mitcheltu/KappaBetaEngineeringProject/Software/WebApp/assets/ocean-background.png

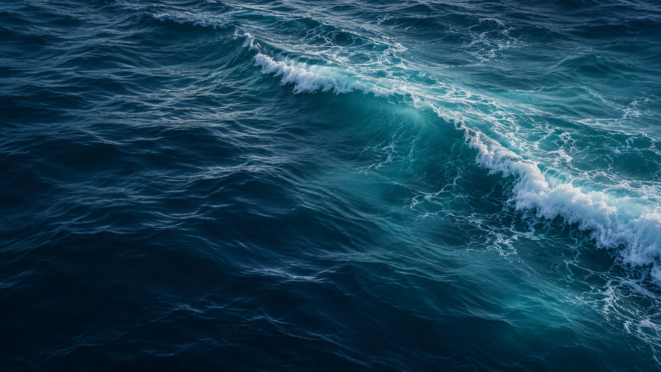
Software/WebApp/assets/ocean-background.png
