mitcheltu/KappaBetaEngineeringProject/Software/archive/README.md

# Archived firmware

`DrowningWearable_legacy.ino` is the older monolithic firmware sketch preserved
during the project consolidation. The active Arduino sketch is the modular
`Software/DrowningWearable/` folder; the archived sketch is not part of the
current build.
