mitcheltu/KappaBetaEngineeringProject/Mechanical/tt_electronics_enclosure.SLDPRT

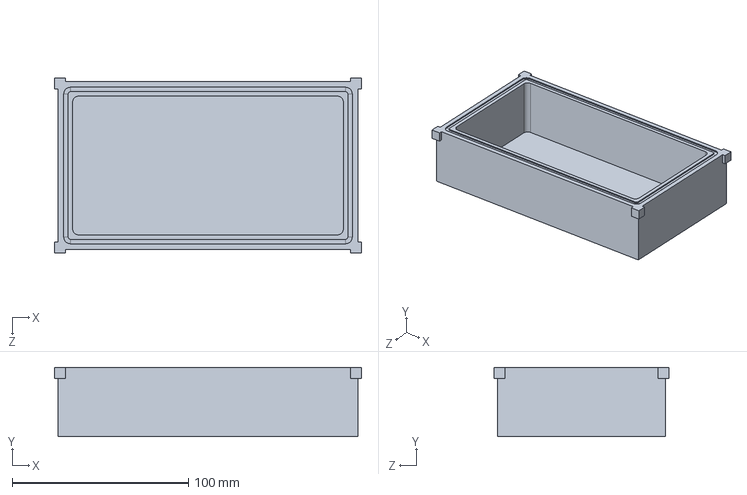
[picture p2: CAD file, 2026-10-26]
Mechanical/tt_electronics_enclosure.SLDPRT
174.3 x 39.4 x 99.4 mm
