mitcheltu/KappaBetaEngineeringProject/Mechanical/tt_base_plate.SLDPRT

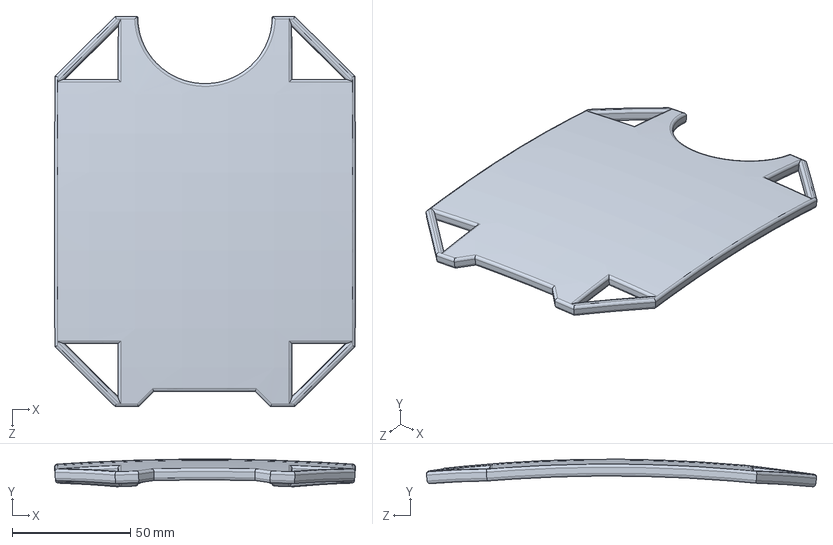
[picture p3: CAD file, 2026-10-26]
Mechanical/tt_base_plate.SLDPRT
127.3 x 11.7 x 165.0 mm
