mitcheltu/KappaBetaEngineeringProject/Mechanical/tt_electronics_lid_v1.SLDPRT

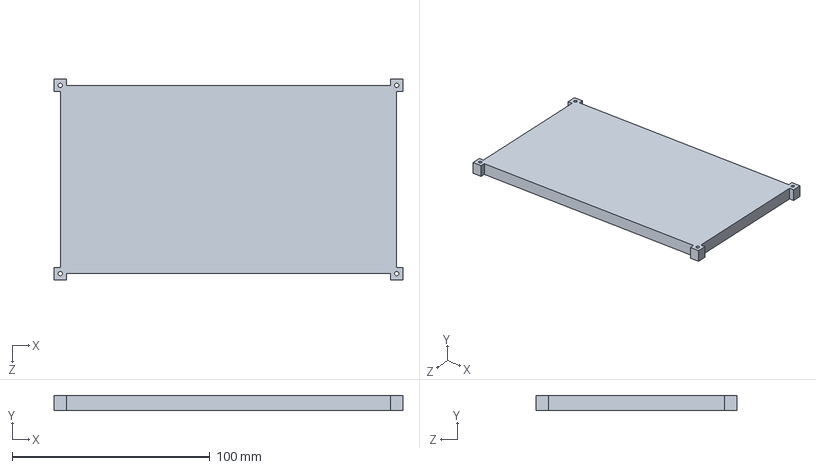
[picture p4: CAD file, 2026-10-26]
Mechanical/tt_electronics_lid_v1.SLDPRT
176.5 x 7.62 x 101.6 mm
