mitcheltu/KappaBetaEngineeringProject/Software/tests/ppg/pulse_peak_cases.csv

case | distance | sample | value
plateaus_threshold | 30 | 0 | 0
plateaus_threshold | 30 | 1 | 0
plateaus_threshold | 30 | 2 | 0
plateaus_threshold | 30 | 3 | 0
plateaus_threshold | 30 | 4 | 0
plateaus_threshold | 30 | 5 | 0
plateaus_threshold | 30 | 6 | 0
plateaus_threshold | 30 | 7 | 0
plateaus_threshold | 30 | 8 | 0
plateaus_threshold | 30 | 9 | 0
plateaus_threshold | 30 | 10 | 1
plateaus_threshold | 30 | 11 | 1
plateaus_threshold | 30 | 12 | 1
plateaus_threshold | 30 | 13 | 1
plateaus_threshold | 30 | 14 | 0
plateaus_threshold | 30 | 15 | 0
plateaus_threshold | 30 | 16 | 0
plateaus_threshold | 30 | 17 | 0
plateaus_threshold | 30 | 18 | 0
plateaus_threshold | 30 | 19 | 0
plateaus_threshold | 30 | 20 | 0
plateaus_threshold | 30 | 21 | 0
plateaus_threshold | 30 | 22 | 0
plateaus_threshold | 30 | 23 | 0
plateaus_threshold | 30 | 24 | 0
plateaus_threshold | 30 | 25 | 0
plateaus_threshold | 30 | 26 | 0
plateaus_threshold | 30 | 27 | 0
plateaus_threshold | 30 | 28 | 0
plateaus_threshold | 30 | 29 | 0
plateaus_threshold | 30 | 30 | 0
plateaus_threshold | 30 | 31 | 0
plateaus_threshold | 30 | 32 | 0
plateaus_threshold | 30 | 33 | 0
plateaus_threshold | 30 | 34 | 0
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
