mitcheltu/KappaBetaEngineeringProject/Software/tests/ppg/pulse_peak_expected.csv

case | sample | prominence
plateaus_threshold | 11 | 1
plateaus_threshold | 46 | 1.5
plateaus_threshold | 90 | 0.29999999999999999
distance_before_prominence | 10 | 1
distance_before_prominence | 45 | 2
distance_before_prominence | 80 | 1
equal_height_distance | 20 | 1
equal_height_distance | 60 | 1
equal_height_distance | 100 | 1
nested_bases | 1 | 1
nested_bases | 3 | 2
nested_bases | 5 | 1
nested_bases | 7 | 4
nested_bases | 9 | 1
mixed_ties_unsupported | 30 | 2
mixed_ties_unsupported | 60 | 2
mixed_ties_unsupported | 100 | 2
mixed_ties_unsupported | 140 | 2
mixed_ties_unsupported | 180 | 2
mixed_ties_unsupported | 230 | 2
mixed_ties_unsupported | 270 | 2
mixed_ties_unsupported | 300 | 2
mixed_ties_unsupported | 350 | 2
mixed_ties_unsupported | 380 | 2
mixed_ties_unsupported | 420 | 2
mixed_ties_unsupported | 470 | 2
mixed_ties_unsupported | 500 | 2
mixed_ties_unsupported | 550 | 2
mixed_ties_unsupported | 590 | 2
mixed_ties_unsupported | 620 | 2
mixed_ties_unsupported | 660 | 2
mixed_ties_unsupported | 710 | 2
mixed_ties_unsupported | 750 | 2
mixed_ties_unsupported | 780 | 2
mixed_ties_unsupported | 830 | 2
mixed_ties_unsupported | 860 | 2
mixed_ties_unsupported | 900 | 2
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
