mitcheltu/KappaBetaEngineeringProject/Software/tests/ppg/oxygen_golden.csv

case | start | full | auto_clear | second | spo2 | valid | concern | active
normal | 80.0 | 60.0 | 0 | 0 | 98 | 1 | nan | 0
normal | 80.0 | 60.0 | 0 | 1 | 98 | 1 | nan | 0
normal | 80.0 | 60.0 | 0 | 2 | 98 | 1 | 0 | 0
normal | 80.0 | 60.0 | 0 | 3 | 98 | 1 | 0 | 0
normal | 80.0 | 60.0 | 0 | 4 | 98 | 1 | 0 | 0
normal | 80.0 | 60.0 | 0 | 5 | 98 | 1 | 0 | 0
normal | 80.0 | 60.0 | 0 | 6 | 98 | 1 | 0 | 0
normal | 80.0 | 60.0 | 0 | 7 | 98 | 1 | 0 | 0
normal | 80.0 | 60.0 | 0 | 8 | 98 | 1 | 0 | 0
normal | 80.0 | 60.0 | 0 | 9 | 98 | 1 | 0 | 0
normal | 80.0 | 60.0 | 0 | 10 | 98 | 1 | 0 | 0
normal | 80.0 | 60.0 | 0 | 11 | 98 | 1 | 0 | 0
normal | 80.0 | 60.0 | 0 | 12 | 98 | 1 | 0 | 0
normal | 80.0 | 60.0 | 0 | 13 | 98 | 1 | 0 | 0
normal | 80.0 | 60.0 | 0 | 14 | 98 | 1 | 0 | 0
normal | 80.0 | 60.0 | 0 | 15 | 98 | 1 | 0 | 0
normal | 80.0 | 60.0 | 0 | 16 | 98 | 1 | 0 | 0
normal | 80.0 | 60.0 | 0 | 17 | 98 | 1 | 0 | 0
normal | 80.0 | 60.0 | 0 | 18 | 98 | 1 | 0 | 0
normal | 80.0 | 60.0 | 0 | 19 | 98 | 1 | 0 | 0
initial_low | 80.0 | 60.0 | 0 | 0 | 60 | 1 | nan | 0
initial_low | 80.0 | 60.0 | 0 | 1 | 60 | 1 | nan | 0
initial_low | 80.0 | 60.0 | 0 | 2 | 60 | 1 | 1 | 0
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
