mitcheltu/KappaBetaEngineeringProject/Software/tests/ppg/pulse_expected.csv

case | max_gap_s | tail_gap_s | n_beats | hr_median | hr_min5 | ibi_cv | amp_tail_ratio | spectral_purity | flat_fraction | kurtosis | rule_score | rule_high_sensitivity | rule_high_specificity | logistic_score | logistic_high_sensitivity | logistic_high_specificity | boosted_score | boosted_high_sensitivity | boosted_high_specificity | cnn_score | cnn_high_sensitivity | cnn_high_specificity
normal | 0.8499999999999996 | 0.8300000000000001 | 19 | 72.28915662650601 | 71.77033492822967 | 0.007170658864360059 | 0.9834620611084873 | 0.9606119034802711 | 0.027517198248905566 | -1.3645968201335694 | 0.0 | 0 | 0 | 0.339762225824646 | 1 | 0 | 0.004903871998024693 | 0 | 0 | 0.25206542015075684 | 0 | 0
brady | 2.2699999999999996 | 2.2699999999999996 | 7 | 27.02702702702704 | 27.027027027027025 | 0.010449778627866509 | 0.8217027037377417 | 0.8758534798037398 | 0.056910569105691054 | -1.2093499450958982 | 1.0 | 1 | 1 | 0.5250571312791127 | 1 | 0 | 0.7862586210842474 | 1 | 1 | 0.6372581720352173 | 1 | 1
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
