mitcheltu/KappaBetaEngineeringProject/Software/tests/ppg/pulse_peaks.csv

case | sample | prominence
normal | 15 | 0.38883108311755621
normal | 99 | 0.99084051001037166
normal | 182 | 1.0218599852947829
normal | 266 | 1.0113197796369453
normal | 349 | 1.0140433324813984
normal | 432 | 1.0135785641496806
normal | 516 | 1.0137369140597867
normal | 599 | 1.0141508830026207
normal | 682 | 1.0133997646689439
normal | 766 | 1.0140496637266154
normal | 849 | 1.0141353097791286
normal | 932 | 1.0134555325873131
normal | 1016 | 1.0138939683185142
normal | 1099 | 1.0153014724942448
normal | 1182 | 1.0130543843935633
normal | 1266 | 1.0065305796033766
normal | 1349 | 1.0434822027916368
normal | 1432 | 0.98666592050735502
normal | 1517 | 0.98725727911364491
brady | 47 | 0.7270062117167988
brady | 263 | 1.0323827692160008
brady | 485 | 1.0333509685395463
brady | 708 | 1.0333314988720381
brady | 930 | 1.0330926958705486
brady | 1152 | 1.0260086210280692
brady | 1373 | 0.84870149961878583
pulse_stops | 15 | 0.40454103545090014
pulse_stops | 99 | 1.0308738638876851
pulse_stops | 182 | 1.070181878693035
pulse_stops | 266 | 1.0521815627560462
pulse_stops | 349 | 1.0547396051088251
pulse_stops | 432 | 1.0544737379258309
pulse_stops | 516 | 1.0552004344574961
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
