mitcheltu/KappaBetaEngineeringProject/Software/tests/ppg/pulse_waveforms.csv

case | sample | raw | prepared
normal | 0 | 100233.648 | 0.125228497419588
normal | 1 | 100540 | 0.16948745901142415
normal | 2 | 100837.938 | 0.21305983128056405
normal | 3 | 101124.523 | 0.25523807856740727
normal | 4 | 101397.039 | 0.29538780627490774
normal | 5 | 101653 | 0.33297037727448814
normal | 6 | 101890.242 | 0.36755163637315319
normal | 7 | 102106.891 | 0.39879936011957268
normal | 8 | 102301.43 | 0.42647356899145888
normal | 9 | 102472.688 | 0.45041384779897248
normal | 10 | 102619.859 | 0.4705269120827551
normal | 11 | 102742.516 | 0.48677637596213896
normal | 12 | 102840.562 | 0.49917543060548963
normal | 13 | 102914.281 | 0.5077821815835879
normal | 14 | 102964.25 | 0.51269681784469312
normal | 15 | 102991.359 | 0.51405958053714418
normal | 16 | 102996.758 | 0.51204858230936323
normal | 17 | 102981.836 | 0.50687678590662411
normal | 18 | 102948.156 | 0.49878777754178671
normal | 19 | 102897.445 | 0.48805028105992299
normal | 20 | 102831.539 | 0.47495160070146647
normal | 21 | 102752.297 | 0.4597903309366283
normal | 22 | 102661.633 | 0.44286873284154399
normal | 23 | 102561.398 | 0.42448516686464161
normal | 24 | 102453.398 | 0.40492691808172798
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
