mitcheltu/KappaBetaEngineeringProject/Software/microcontrollerFinal/DepthSensor.h

#pragma once

#include <Arduino.h>
#include <MS5837.h>
#include <Wire.h>
#include <cmath>
#include <cstddef>
#include <cstdint>

#include "FirmwareConfig.h"

#ifndef MS5837_H_BLUEROBOTICS
#error "Select BlueRobotics MS5837 Library by BlueRobotics; another MS5837 library was found."
#endif

// Quality is descriptive sensor state. It is deliberately separate from any
// fusion weights, action thresholds or risk scores.
using DepthQualityFlags = uint16_t;
namespace DepthQuality {
constexpr DepthQualityFlags NONE = 0;
constexpr DepthQualityFlags SENSOR_INVALID = 1u << 0;
constexpr DepthQualityFlags I2C_ERROR = 1u << 1;
constexpr DepthQualityFlags MISSING_BASELINE = 1u << 2;
constexpr DepthQualityFlags OUTLIER_REJECTED = 1u << 3;
constexpr DepthQualityFlags STALE = 1u << 4;
constexpr DepthQualityFlags RATE_UNAVAILABLE = 1u << 5;
constexpr DepthQualityFlags FILTER_WARMUP = 1u << 6;
constexpr DepthQualityFlags STOPPED = 1u << 7;
}

struct DepthSensorConfig {
  uint32_t samplePeriodMs = 200; // PROVISIONAL/TBD; 5 Hz initial cadence.
  float waterDensityKgM3 = 1000.0f; // PROVISIONAL/TBD freshwater/pool density.

  // These filter values are implementation defaults only, not safety-calibrated.
  uint8_t hampelWindowSamples = 5; // PROVISIONAL/TBD.
  float hampelDeviationThreshold = 3.0f; // PROVISIONAL/TBD MAD multiplier.
  float hampelMinimumDeviationM = 0.01f; // PROVISIONAL/TBD MAD floor.
  float emaAlpha = 0.25f; // PROVISIONAL/TBD.
  uint32_t regressionWindowMs = Config::DEPTH_REGRESSION_WINDOW_MS;
  uint8_t minimumRegressionSamples = 3; // PROVISIONAL/TBD.
  uint32_t staleAfterMs = Config::DEPTH_STALE_AFTER_MS; // PROVISIONAL/TBD.

  float minimumPressurePa = 0.0f;
  float maximumPressurePa = 3000000.0f;
  float minimumTemperatureC = -20.0f;
  float maximumTemperatureC = 85.0f;
};

struct DepthReading {
  uint64_t timestampUs = 0;
  float pressurePa = NAN;
  float temperatureC = NAN;
  float surfacePressurePa = NAN;
  float rawDepthM = NAN;
  float filteredDepthM = NAN;
  float depthRateMps = NAN;
  uint64_t rateWindowStartUs = 0;
  uint64_t rateWindowEndUs = 0;
  bool sensorValid = false;
  bool depthValid = false;
  bool rateValid = false;
  DepthQualityFlags qualityFlags = DepthQuality::SENSOR_INVALID |
                                    DepthQuality::MISSING_BASELINE |
                                    DepthQuality::RATE_UNAVAILABLE;
};

enum class DepthServiceEvent : uint8_t {
  NONE,
  SAMPLE_PUBLISHED,
  SURFACE_ZERO_PUBLISHED,
  CONVERSION_FAILED,
  SURFACE_ZERO_FAILED,
};

class DepthSensor {
 public:
  explicit DepthSensor(const DepthSensorConfig& config = DepthSensorConfig{});

  // The official MS5837 1.1.1 implementation uses the global Wire object and
  // the sensor's fixed 0x76 address internally. The arguments mirror ImuSensor
  // for call-site consistency and identify the bus/address being configured.
  bool begin(TwoWire& bus, uint8_t address);

  // Queues a fresh surface-pressure conversion and clears dive-only state.
  bool startDive();
  void stopDive();

  // Runs one nonblocking state-machine step. Call on every loop pass.
  DepthServiceEvent service();

  // Retained for standalone callers while they migrate to service().
  bool due(uint64_t nowUs) const;
  bool update();

  bool ready() const { return ready_; }
  bool diveActive() const { return diveActive_; }
  bool hasReading() const { return reading_.timestampUs != 0; }
  const DepthReading& reading() const { return reading_; }
  DepthReading snapshot(uint64_t nowUs) const;
  bool isStale(uint64_t nowUs) const;
  const DepthSensorConfig& config() const { return config_; }

 private:
  static constexpr size_t HISTORY_CAPACITY = 64;
  static constexpr uint64_t CONVERSION_TIME_US = 20000;

  enum class ConversionState : uint8_t {
    IDLE,
    WAITING_PRESSURE,
    WAITING_TEMPERATURE,
  };

  enum class ConversionKind : uint8_t {
    NORMAL_SAMPLE,
    SURFACE_ZERO,
  };

  struct HistorySample {
    uint64_t timestampUs = 0;
    float depthM = NAN;
    bool valid = false;
  };

  void invalidateReading(DepthQualityFlags flags);
  void invalidateReading(uint64_t timestampUs, float pressurePa,
                         float temperatureC, DepthQualityFlags flags);
  void resetDiveState();
  bool sensorPresent() const;
  bool writeCommand(uint8_t command);
  bool readAdc(uint32_t& value);
  bool readCalibrationWord(uint8_t index, uint16_t& value);
  bool loadCalibration();
  uint8_t crc4(uint16_t prom[8]) const;
  bool startConversion(uint8_t command, uint64_t timestampUs);
  bool compensate(uint32_t pressureAdc, uint32_t temperatureAdc,
                  float& pressurePa, float& temperatureC) const;
  DepthServiceEvent failConversion(uint64_t timestampUs,
                                   DepthQualityFlags flags);
  void processSample(uint64_t timestampUs, float pressurePa, float temperatureC);
  void updateDepthRate(uint64_t timestampUs);
  bool isHampelOutlier(float depthM, bool& warming);
  void appendRawHistory(float depthM, uint64_t timestampUs);
  void appendFilteredHistory(float depthM, uint64_t timestampUs);

  DepthSensorConfig config_;
  TwoWire* bus_ = nullptr;
  uint8_t address_ = 0;
  uint16_t calibration_[8] = {};
  bool ready_ = false;
  bool diveActive_ = false;
  bool zeroPending_ = false;
  ConversionState conversionState_ = ConversionState::IDLE;
  ConversionKind conversionKind_ = ConversionKind::NORMAL_SAMPLE;
  uint64_t conversionDeadlineUs_ = 0;
  uint32_t pressureAdc_ = 0;
  float surfacePressurePa_ = NAN;
  float previousFilteredDepthM_ = NAN;
  bool filteredDepthValid_ = false;
  uint64_t lastSampleUs_ = 0;
  bool sampleClockValid_ = false;
  uint64_t lastValidSampleUs_ = 0;
  DepthReading reading_{};
  HistorySample rawHistory_[HISTORY_CAPACITY]{};
  HistorySample filteredHistory_[HISTORY_CAPACITY]{};
  size_t rawHistoryCount_ = 0;
  size_t filteredHistoryCount_ = 0;
};
