mitcheltu/KappaBetaEngineeringProject/Software/depthSoftware/DepthSensor.h

#pragma once

// Keep the standalone sketch and final integration on one depth implementation
// until the module is ready to be split into a separately packaged library.
#include "../microcontrollerFinal/DepthSensor.h"
