mitcheltu/KappaBetaEngineeringProject/Software/microcontrollerFinal/SinkRateEstimator.h

#pragma once

#include "DepthSensor.h"

struct SinkRateComparison {
  uint64_t timestampUs = 0;
  uint64_t inputStartUs = 0;
  uint64_t inputEndUs = 0;
  float measuredRateMps = NAN;
  float naturalSinkingSpeedMps = NAN;
  float rateDifferenceMps = NAN;
  // Normalized sink-risk component for sensor fusion. This is not a calibrated
  // clinical probability; valid values are in [0, 1].
  float sinkRiskScore = NAN;
  bool valid = false;
};

namespace SinkRateConfig {
// Fixed until the project has a validated hydrodynamic calibration.
constexpr float DRAG_COEFFICIENT = 0.85f;
}

class SinkRateEstimator {
 public:
  // Profile values are supplied by the caller. Height/profile collection and
  // displaced-volume estimation remain outside this class and DepthSensor.
  SinkRateEstimator(float totalMassKg, float displacedVolumeM3,
                    float waterDensityKgM3, float projectedAreaM2,
                    float gravityMps2 = 9.81f);

  bool valid() const { return valid_; }
  float naturalSinkingSpeedMps() const { return naturalSinkingSpeedMps_; }
  SinkRateComparison compare(float measuredRateMps) const;
  SinkRateComparison compare(const DepthReading& reading) const;

 private:
  float naturalSinkingSpeedMps_ = NAN;
  bool valid_ = false;
};
