mitcheltu/KappaBetaEngineeringProject/(commit log)

2026-10-26 Add CAD models and project pseudocode
    [tt_base_plate.SLDPRT, tt_electronics_enclosure.SLDPRT, tt_electronics_lid_v1.SLDPRT]
2026-11-02 first couple git pushes
2026-11-02 Add sensor fusion mappings and IMU orientation context
2026-11-02 Add sensor quality propagation and validation
2026-11-02 Finalize sensor fusion build and documentation
2026-11-04 Track remaining repository file
2026-11-04 feat: add Rev F bench-valve firmware with sensor telemetry
    initialize and validate BMI270 IMU, MS5837 pressure sensor, and MAX30102 PPG hardware
    add surface-zero depth calibration and robust sensor recovery/reset logic
    implement manual bench control for SOS vibration and valve actuation
    add BLE telemetry publishing for depth, motion, optical, and system state
    expose serial commands (z, sos, off) for manual testing and shutdown
    monitor battery level and actuator state to reject unsafe test conditions
    [DrowningWearable.ino]
2026-11-04 feat: add Rev F bench-valve firmware with sensor telemetry initialize and validate BMI270 IMU, MS5837 pressure sensor, and MAX30102 PPG hardware add surface-zero depth calibration and robust sensor r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
    [BenchSequence.h, CheckedBMI270.h, FirmwareConfig.h, TelemetryProtocol.h, bench_sequence_test.cpp]
2026-11-05 feat(firmware): modularize Arduino sketch and add sensor history sync
    - Split firmware into sensor, actuator, Bluetooth, and command modules
    - Add PSRAM history buffering and resumable browser storage
    - Switch to official BlueRobotics MS5837 and pump controls
    - Update build configuration, setup docs, and tests
2026-11-05 refactor(firmware): organize Arduino files into IDE-ready sketch folder
    - Move firmware tabs, headers, and libraries.txt into Software/DrowningWearable
    - Update build script, test include paths, and documentation references
    - Add Arduino IDE setup and upload instructions
2026-11-06 feat: add IMU risk evaluator scaffold
2026-11-06 chore: organize mechanical files
    [tt_base_plate.SLDPRT, tt_electronics_enclosure.SLDPRT, tt_electronics_lid_v1.SLDPRT]
2026-11-07 temp feat: change vibration motor to esp32 blue light
    [Actuators.ino, BenchSequence.h, Bluetooth.ino, Depth.ino, Diagnostics.h, DrowningWearable.ino, FirmwareConfig.h, FirmwareShared.h]
2026-11-08 Implement depth sensor module
2026-11-09 Document depth sensor module
2026-11-09 Fix drag coefficient at 0.85
    [SinkRateEstimator.h, SinkRateEstimator.ino]
2026-11-09 Add native iOS app, profile sync, and Rev I wearable demo
    - Add offline iOS client and CI workflow
    - Send saved app settings to compatible firmware after history import
    - Organize demo firmware under testsAndDemo
    - Update web telemetry for vibration and pump timing
    - Add SolidWorks base plate, enclosure, and lid files
    [tt_base_plate.SLDPRT, tt_electronics_enclosure.SLDPRT, tt_electronics_lid_v1.SLDPRT]
2026-11-09 Add standalone ESP32-S3 PPG module with oxygen and pulse-loss detection
    [oxygen_golden.csv, pulse_expected.csv, pulse_peak_cases.csv, pulse_peak_expected.csv, pulse_peaks.csv, pulse_waveforms.csv]
2026-11-10 Implement sensor acquisition and processing tasks
2026-11-10 Reject mistimed IMU windows and defer PPG analysis
2026-11-11 Add CNN gate and aligned sensor risk rounds
2026-11-11 Add gated sensor risk fusion output
